MyRetroStore/Commodore-PET-Universal-Dynamic/(commit log)

2025-08-03 Add BOM
    [BOM.csv]
2025-08-04 Add Gerber files
    [Commodore PET Universal Dynamic-B_Cu.gbr, Commodore PET Universal Dynamic-B_Mask.gbr, Commodore PET Universal Dynamic-B_Paste.gbr, Commodore PET Universal Dynamic-B_Silkscreen.gbr, Commodore PET Universal Dynamic-Edge_Cuts.gbr, Commodore PET Universal Dynamic-F_Cu.gbr, Commodore PET Universal Dynamic-F_Mask.gbr, Commodore PET Universal Dynamic-F_Paste.gbr]
2025-08-04 Add schematics
    [Commodore PET Universal Dynamic.kicad_sch, cassette_keyboard.kicad_sch, cpu_memory.kicad_sch, crtc-sync-buffers.kicad_sch, display_address_mux.kicad_sch, dot_gen.kicad_sch, ieee-488.kicad_sch, master_timing.kicad_sch]
2025-08-04 Update capacitor voltages in BOM
    [BOM.csv]
2025-09-02 Add interactive HTML BOM
